urish/aramcon-badge/firmware/clicker/README.md

# Badge Clicker

## Installation

Copy [code.py](code.py) and [badgeio.py](../lib/badgeio.py) to your badge's USB Drive

## Usage

* Left button: Previous slide
* Right button: Next slide

Enjoy!

## Credits

* Applause sound taken from http://soundbible.com/2087-Audience-Applause.html
