urish/aramcon-badge/firmware/touch-piano/music.bmp

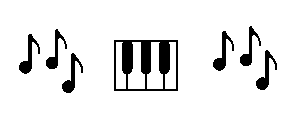
firmware/touch-piano/music.bmp
