urish/aramcon-badge/firmware/touch-screen/rgb.bmp

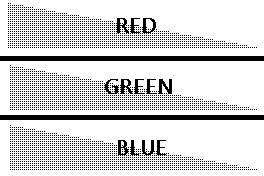
firmware/touch-screen/rgb.bmp
