urish/aramcon-badge/firmware/welcome/assets/welcome.bmp

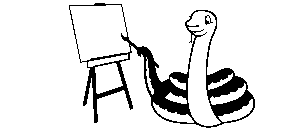
firmware/welcome/assets/welcome.bmp
