urish/aramcon-badge/pcbv2/3d-models/SFH11-xxPC-D03-ST-BK.STEP

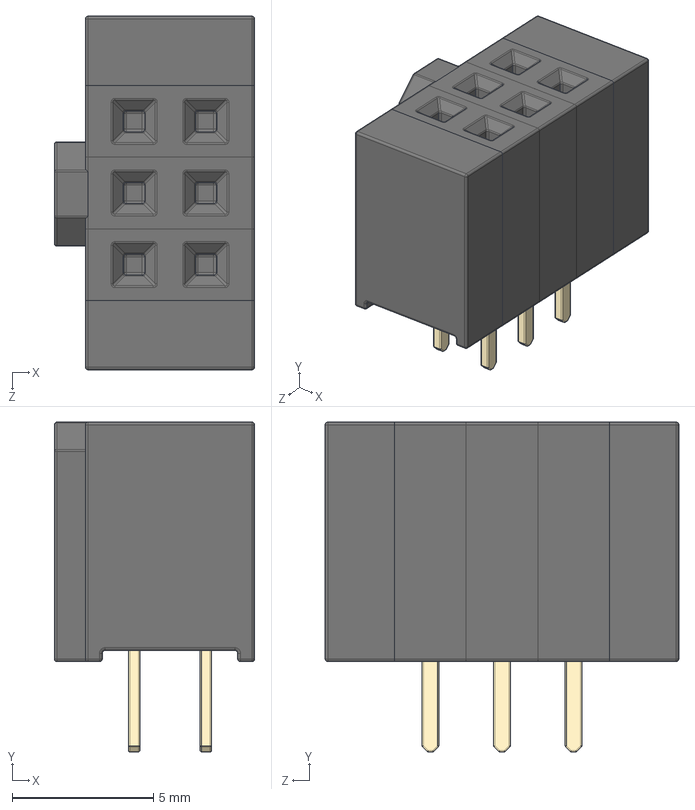
[picture p5: CAD file, 2019-10-17]
pcbv2/3d-models/SFH11-xxPC-D03-ST-BK.STEP
7.10 x 11.7 x 12.5 mm
body section with ST gold pins x 4
end x 2
Polarizing Key
