urish/aramcon-badge/pcbv2/3d-models/switch.step

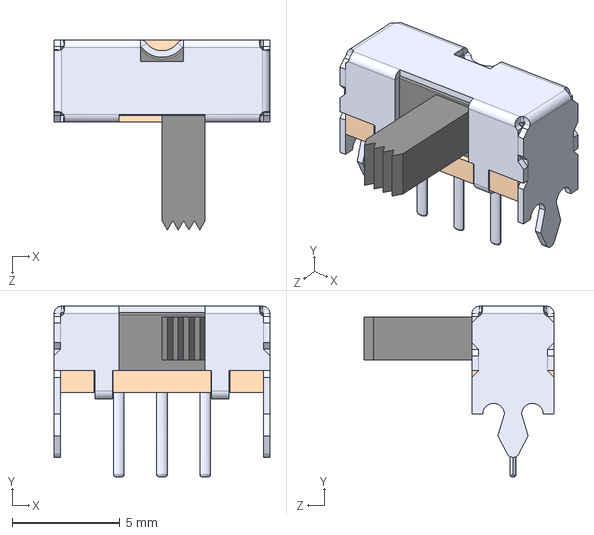
[picture p6: CAD file, 2019-10-12]
pcbv2/3d-models/switch.step
10.0 x 7.90 x 8.80 mm
