urish/aramcon-badge/(list of files, cad)

Other CAD files:
pcbv2/3d-models/switch.3mf
