urish/aramcon-badge/(commit log)

2018-11-23 feat: create KiCad project, add VS1053 symbol
    [badge.kicad_pcb, badge.sch]
2018-11-23 fix: wrong pin name in VS1053 symbol
2018-11-23 feat: add some initial connections to the mp3 player module
    [badge.sch]
2018-11-26 feat: add audio jack (TRRS) connector
    also assign footprints to symbols
    [badge.sch]
2018-12-10 Add MP3 breakout
    [badge.sch]
2018-12-10 Finish mp3 chip schematic
    [badge.sch]
2018-12-10 chore: add gitignore
    based on https://github.com/github/gitignore/blob/master/KiCad.gitignore
2018-12-10 Assign footprints
    [badge.sch]
2018-12-10 Start PCB layout
    [badge.kicad_pcb, badge.sch]
2018-12-10 Finish initial PCB layout
    This is only the sound module
    [badge.kicad_pcb, badge.sch]
2018-12-10 Update gerber (manufacturing) settings
    according to PCBWay guide:
    https://www.pcbway.com/blog/help_center/Generate_Gerber_file_from_Kicad.html
    [badge.kicad_pcb]
2018-12-20 Fix silk screen text: MOSI to MISO
    [badge.kicad_pcb]
2018-12-20 Move MP3 schematic to a new sheet
    - add micro usb connector
    - add ebyte module
    [MP3.sch, badge.sch]
2018-12-20 Add footprint for ebyte E73 nRF52840 module
2018-12-20 fix pin name in E73 symbol
2018-12-20 Fix names in MP3 sheet
    Add programming connector
    [MP3.sch, badge.sch]
2018-12-20 Mark pin 1 on silk screen for the VS1053B chip
    [badge.kicad_pcb]
2018-12-24 Add schematic for E paper display
    [Epaper.sch, MP3.sch, badge.sch]
2018-12-24 Fix ERC problems
    [Epaper.sch, MP3.sch, badge.sch]
2018-12-24 Add touch button symbols + footprints
    [Epaper.sch, badge.sch]
2018-12-24 Routing the CPU
    [MP3.sch, badge.kicad_pcb, badge.sch]
2018-12-24 Add courtyard layer to footprints
2018-12-24 Finish routing for display
    [badge.kicad_pcb]
2018-12-24 fix: add missing pin in E73 symbol
    Pin #1 was missing (P1.11)
    [badge.sch]
2018-12-24 Add power and indication LEDs
    [badge.kicad_pcb, badge.sch]
2018-12-24 Add silk screen text for breakout pins
    [badge.kicad_pcb]
2018-12-25 Add logo footprint
    [badge.kicad_pcb]
2018-12-25 Make logo smaller
    Resize with `-f 0.5` parameter for svg2mod
    [badge.kicad_pcb]
2018-12-25 Remove Paste layer from touch buttons
    [badge.kicad_pcb]
2018-12-25 feat: add conference logo to pcb
    [badge.kicad_pcb]
2018-12-29 fix(pcb): remove copper under BLE module antenna
    [badge.kicad_pcb]
2018-12-31 fix(pcb): remove "R7" from silk screen
    [badge.kicad_pcb]
2019-01-02 fix(epaper): update nRF pins for our own PCB
2019-01-02 Fix reversed connector for EPD
    [Epaper.sch, MP3.sch, badge.kicad_pcb]
2019-01-04 feat(pcb): add 2 neopixels
    [badge.kicad_pcb, badge.sch]
2019-01-05 add sample graphics for 2.7" and 2.9" displays
2019-01-12 feat(zephyr): initial working zephyr app
    simple blink app + board definition
2019-01-12 feat(zephyr): set up NeoPixel driver
2019-01-14 cleanup(pcb): remove touch buttons / slider
    [badge.kicad_pcb, badge.sch]
2019-01-14 feat(pcb): new board shape
    [badge-outline.dxf, badge.kicad_pcb]
2019-01-14 feat(pcb): add two more neopixels (schematic)
    [badge.sch]
2019-01-14 feat(pcb): add modified version of svg2mod
    Includes Python 3 fixes and some of the changes from:
    https://github.com/mtl/svg2mod/pull/26
2019-01-14 feat(pcb): create new footprint with board shape
    based on Elad's design. The shape is automatically generated from
    "board-shape.svg", along with the bottom silk screen and hints
    where to place various components
    [badge-outline.dxf, badge.kicad_pcb]
2019-01-14 feat(pcb): Add 3 Cherry MX buttons
    [badge.kicad_pcb, badge.sch]
2019-01-14 feat(pcb): add standard ARM-JTAG connector
    [badge.kicad_pcb, badge.sch]
2019-01-17 feat(pcb): reposition audio jack, display connector
    [badge.kicad_pcb]
2019-01-18 feat(pcb): mark pin 1 of the SWD connector
    [badge.kicad_pcb]
2019-01-18 feat(PCB): add SAO
    https://hackaday.com/2018/06/21/this-is-the-year-conference-badges-get-their-own-badges/shitty-add-on-standard/
    [badge.kicad_pcb, badge.sch]
2019-01-19 Added AA battery clip and regulator, only foorprint and symbols, no wiring yet.
    [badge.kicad_pcb, badge.sch]
2019-01-19 fix(pcb): use relative paths in symbol table
2019-01-19 fix(pcb): move conference logo down
    [badge.kicad_pcb]
2019-01-19 cleanup(PCB): remove display/sound headers from schematic
    [MP3.sch, badge.sch]
2019-01-19 cleanup(pcb): remove display / sound connectors from layout
    [badge.kicad_pcb]
2019-01-20 fix(pcb): improve board shape smoothness
    [badge.kicad_pcb]
2019-01-20 fix(pcb): move BLE module to edge of board
    we need to reroute everything again :q
    [badge.kicad_pcb]
2019-01-21 Add missing pins to E73 symbol
    [badge.sch]
2019-01-21 Add Flash memory + connect battery and step-up IC
    [MP3.sch, badge.sch]
2019-01-21 Add vibrator
    [badge.sch]
2019-01-21 PCB routing
    [badge.kicad_pcb, badge.sch]
2019-01-21 feat(pcb): complete layout
    [badge.kicad_pcb]
2019-01-21 feat(pcb): add texts to switch, indicate SAO VCC pin
    [badge.kicad_pcb]
2019-01-21 fix(pcb): change step-up resistor to 390R
    400R is not a common value, 390 is.
    [badge.kicad_pcb, badge.sch]
2019-01-23 feat(pcb): add tiny-sao pcb
    [tiny-sao.kicad_pcb, tiny-sao.sch]
2019-01-24 refactor(pcb): move power schematic to a separate sheet
    [Epaper.sch, MP3.sch, badge.kicad_pcb, badge.sch, power.sch]
2019-01-24 feat(pcb): add battery reverse polarity protection
    [badge.kicad_pcb, power.sch]
2019-01-25 feat(pcb): add indication LED to tiny-sao
    [tiny-sao.kicad_pcb, tiny-sao.sch]
2019-01-25 feat(pcb): add LIS2DH12TR accelerometer
    [badge.kicad_pcb, badge.sch]
2019-01-25 cleanup(pcb): remove unused files
    also move all symbol libraries into the `lib` folder
2019-02-03 fix(pcb): mark pin 1 of the flash memory (U5)
    [badge.kicad_pcb]
2019-02-04 moved C16 and moved pads in EBYTE footprint
    moved C16 closer to U4.
    [badge.kicad_pcb]
2019-02-04 fix(pcb): C16 label position
    [badge.kicad_pcb]
2019-02-05 feat(epaper): implement basic IL0373 driver
    no support for partial updates at this stage
2019-02-08 fix(zephyr): fix ws2812 compilation error
    Move WS2812 settings to device tree, per changes in Zephyr:
    https://github.com/zephyrproject-rtos/zephyr/commit/8b691f50ca
2019-02-08 feat(zephyr): add button definitions to board dts
2019-02-08 feat(zephyr): switch to RTT logger
    open virtual logging console over JLink
2019-02-08 fix(zephyr): fix board clock configuration
    use RC for lowfreq clock (instead of external crystal that we don't have)
2019-02-08 fix(zephyr): fix SPI and I2C pin configuration
    they were conflicting with the ePaper pins, causing it not to function
    also remove uart0, we have no uart pins on our board
2019-02-08 feat(zephyr): add epaper device
    seems to be half-working on the waveshare module
2019-02-09 feat(zephyr): display battery voltage
2019-02-09 fix(zephyr): board configuration
2019-02-09 fix(pcb): hide switch designators from silkscreen
    [badge.kicad_pcb]
2019-02-09 feat(zephyr): add accelerometer dts
2019-02-10 feat(pcb): add test-points for programming
    add GND, SWCLK, SWDIO, 3V3 with standard 0.1" spacing
    [badge.kicad_pcb, badge.sch]
2019-02-11 feat(zephyr): add code to test buttons
2019-02-11 fix(zephyr): invert buttons, simplify loop code
2019-02-11 fix(zephyr): fix pin collision between SPI2 and SW2
2019-02-11 feat(zephyr): add vibration motor (controlled by middle button)
2019-02-15 refactored buttons out of zephyr code
2019-02-15 removed button aliases
2019-02-17 feat(nametags): implement nametags app + webpage
    🛫
2019-02-22 refactored out led code
2019-02-22 Refactored vibration motor out of main
2019-02-22 fixed magic number in buttons.c
2019-02-22 moved drivers to seperate folder
2019-02-22 refactored battery voltage out of main
2019-02-23 fix(pcb): update R11 value to 0.47R
    This is due to switching our EPaper display panel to GDEW029T5,
    which requires a smaller resistor value than the original Waveshare panel
    [Epaper.sch, badge.kicad_pcb]
2019-02-28 feat(zephyr) VS1003B driver skeleton
    + code for basic sanity test
2019-03-15 fix(pcb): correct "Placement Type" setting
    - SMD placement for U3, BT1
    - Virtual placement for SHAPE, svg2mod
    - Also Virtual for J6, as it is not assembled by default
    [badge.kicad_pcb]
2019-04-13 feat(zephyr): migrate to good-display driver
2019-04-15 feat(web): implement device filtering
    look at the query param `b` to decide which badge we want to connect to
2019-04-15 feat(nametags): report battery voltage to web app
    also update the web app to display the voltage
2019-04-15 feat(nametags): implement keyboard driver
    it exposes a queue of key events, and includes a debouncing mechanism
2019-04-15 refactor(nametags): break code to drivers
2019-04-15 feat(nametags): implement led breathe
    using PWM
2019-04-16 feat(nametags): implement BLE scanner
    this allows mass-remote control of LEDs
2019-04-16 fix(web): switch font to Roboto
2019-04-17 fix(hardware-test): fix sound driver
    send the correct buffer size when writing to SPI
2019-04-17 feat(hardware-test): sound driver
    implement missing vs1053 functionality
2019-04-17 added sound driver from hwtest
2019-04-18 fix(nametags): improve sound driver performance
    - don't perform double sanity check
    - initialize sound faster in case the chip is missing
    - play 500hz tone (instead of 3khz)
2019-04-23 feat(js): driver for IL0373 display
2019-04-23 fix(js): speed up il0373
    call spi.write() instead of spi.send()
2019-04-24 fix(clock): auto update time every minute
    [main.py]
2019-05-08 fix(pcb): add capacitor for the buzzer
    [badge.kicad_pcb, badge.sch]
2019-05-16 Added circuitpython test programs
2019-06-27 Add setup instructions for circuitpython
2019-08-13 Added customizable-badge to circuitpython apps
2019-08-13 feat: add badgeio library for CircuitPython
2019-08-13 feat(badgeio): add battery_voltage property
2019-08-13 feat(badgeio): add i2c property
2019-08-13 fix(badgeio): NEOPIXELS → NEOPIXEL
    sync with change in our CircuitPython board definition
2019-08-13 feat(badgeio): add display, display_bus, spi
2019-08-13 refactor: make circuitpython the default firmware
    moved zephyr firmware to a separate branch:
    https://github.com/urish/aramcon-badge/tree/zephyr-firmware
    and removed all zephyr related files from the master branch.
    Updated the README accordingly
2019-08-28 cleanup(pcb): remove tiny-sao board
    move to own repository:
    https://github.com/urish/ctf-shittyaddon
    [tiny-sao.kicad_pcb, tiny-sao.sch]
2019-08-29 feat(firmware): start porting nametags to python
    currently displays the conference banner + qr code
2019-08-29 feat(firmware): add sound support to badgeio
    also add sineTest() method to vs1053 driver
2019-08-29 fix(clock): use new display API
    [main.py]
2019-08-30 Fixed some circuitpython drivers
2019-08-30 Rock paper scissors: Fixed bug in join_game
    [code.py]
2019-08-30 fix(rock-paper-scissor): don't block if session disconnects
    [code.py]
2019-08-31 feat(nametags): persistence + bug fixes
    * persistence - store bitmap to flash
    * improve LED spinner
    * implement battery voltage characteristic
    * resume advertising after disconnect
    * rename main.py → code.py for consistency with other projects
    [bitmapsave.py, code.py, led_spinner.py, main.py, name_server.py, ui.py]
2019-09-02 doc(pcb): add illustration of the board front
2019-09-22 feat(badgeio): lazy init accelerometer
2019-10-05 feat(pcbv2): start working on the 2020 edition
    Changes so far:
    1. Replace the Micro USB connector with a USB Type C connector
    2. Upgrade ShittyAddon to V. 1.69bis
    3. Remove the VS1003 audio CODEC chip, audio jack, and related components
    4. Remove the custom board shape
    5. Add SOICbite connector for programming (in place of the TPs)
    References:
    * SOICbite - https://github.com/SimonMerrett/SOICbite
    * Shitty Addon V. 1.69bis - https://hackaday.io/project/52950-shitty-add-ons/log/159806-introducing-the-shitty-add-on-v169bis-standard
    [Epaper.sch, badge2.kicad_pcb, badge2.sch, power.sch]
2019-10-08 feat(pcbv2): add LiPo module
    [Epaper.sch, badge2.sch, lipo.sch, power.sch]
2019-10-11 feat(pcbv2): remove 2 neopixels
    We only want two in the new design
    [badge2.sch]
2019-10-11 feat(pcbv2): replace keyboard buttons with 6x6 buttons
    Now we have 4 buttons: top/left/right/down instead of the 3 keyboard buttons we used to have
    [badge2.kicad_pcb, badge2.sch, lipo.sch]
2019-10-11 feat(pcbv2): new design / board layout
    see badge-2020.svg
    [badge2.kicad_pcb]
2019-10-11 feat(pcbv2): add action button
    [badge2.kicad_pcb, badge2.sch]
2019-10-11 refactor(pcbv2): move accelerometer to own sheet
    [Epaper.sch, accelerometer.sch, badge2.kicad_pcb, badge2.sch, lipo.sch, power.sch]
2019-10-11 feat(pcbv2): add FM module connector
    [badge2.kicad_pcb, badge2.sch]
2019-10-11 fix(pcbv2): move usb-c connector a bit down
    so it doesn't collide with the down button
    [badge2.kicad_pcb]
2019-10-11 feat(pcbv2): add reset button
    [badge2.kicad_pcb, badge2.sch]
2019-10-12 fix(pcbv2): simplify board SVG
    [badge2.kicad_pcb]
2019-10-12 fix(pcbv2): move power components together
    [badge2.kicad_pcb]
2019-10-12 feat(pcbv2): add 3d model for the EByte module
    [E73-2G4M08S1C.scad, badge2.kicad_pcb]
2019-10-12 feat(pcbv2): add copper zones
    [badge2.kicad_pcb]
2019-10-12 feat(pcbv2): 3d models for buttons + switch
    [badge2.kicad_pcb, switch.step]
2019-10-12 feat(pcbv2): move SOICbite, add reset to PCB
    move SOICbite to the other side of the board, add reset button to the PCB,
    start routing flash and power LED
    [badge2.kicad_pcb]
2019-10-16 cleanup(pcbv2): remove Cortex-M connector
    [badge2.kicad_pcb, badge2.sch]
2019-10-16 feat(pcbv2): replace flash memory
    Upgrade flash to 128MBit (16MByte):
    GD25Q16C → W25Q128JVS
    The new flash chip has a different package (SOIC-8 208-mil), so the PCB was updated with the new footprint
    [badge2.kicad_pcb, badge2.sch]
2019-10-17 fix(pcbv2): reconnect VUSB pin
    also add decoupling cap on VUSB, as recommended in nRF reference design
    [badge2.kicad_pcb, badge2.sch]
2019-10-17 feat(pcbv2): replace SAO footprint with the official one
    also add a 3D model
    [SFH11-xxPC-D03-ST-BK.STEP, badge2.kicad_pcb, badge2.sch]
2019-10-18 fix(pcbv2): SAO orientation
    Make it compatible with last year's badge
    [badge2.kicad_pcb]
2019-10-22 feat(pcbv2): add LCSC part# for USB Type C connector
    [badge2.sch]
2019-10-24 feat(pcbv2): add part numbers to schematics
    mostly LCSC / Digikey. Some components still missing, will
    add them soon.
    [Epaper.sch, accelerometer.sch, badge2.sch, power.sch]
2019-10-25 Added bcaaapc foorprint for AAA battery holder. This is based on http://www.memoryprotectiondevices.com/datasheets/BCAAAPC-datasheet.pdf
2019-10-25 Downloaded a JST-B2B-PH-K-S socket footprint and labeled its pins.
2019-10-25 feat(pcbv2): add BOM part numbers
    most parts there there, still missing a few
    [Epaper.sch, badge2.sch, lipo.sch, power.sch]
2019-10-25 feat(pcbv2): add missing parts to BOM
    [badge2.sch]
2019-10-30 feat(pcbv2): add cross hole
    [badge2.kicad_pcb]
2019-10-30 fix(pcbv2): adjust clearance for U7, USB-C pads
    [badge2.kicad_pcb]
2019-10-30 fix(pcbv2): move SOICbite silk labels
    [badge2.kicad_pcb]
2019-11-01 Modify JST and AAA sockets to have matching pin labels
2019-11-01 Placed new AAA and JST battery holders on PCB
    [badge2.kicad_pcb]
2019-11-01 Added battery holders BOM data
    [Epaper.sch, accelerometer.sch, badge2.sch, lipo.sch, power.sch]
2019-11-01 fix(pcbv2): broken schematic symbols
    [Epaper.sch, accelerometer.sch, badge2.sch, lipo.sch, power.sch, switch.3mf]
2019-11-01 fix(pcbv2): sprinkle no-connection flags
    [badge2.sch]
2019-11-01 fix(pcbv2): sync pcb with schematic
    [badge2.kicad_pcb]
2019-11-01 feat(pcbv2): connect remaining pins of FM module
    also remove unused MISO pin
    [badge2.sch]
2019-11-01 fix(pcbv2): remove AMS1117-3.3 regulator
    We already have RT9013-33GB that does the same.
    This also fixes an issue where the power switch would not be able to cut USB/LiPo power.
    Also move LiPo circuit into power schematic.
    [Epaper.sch, accelerometer.sch, badge2.sch, lipo.sch, power.sch]
2019-11-01 fix(pcbv2): remove references to missing fp libraries
2019-11-01 feat(pcbv2): wiring
    [badge2.kicad_pcb]
2019-11-01 feat(pcbv2): even more wiring
    [badge2.kicad_pcb]
2019-11-01 feat(pcbv2): finish wiring
    [badge2.kicad_pcb]
2019-11-03 fix(pcbv2): add pull-down resistor to vibration motor
    This ensures the vibration motor doesn't randomally go start before the MCU configures the respective GPIO to output
    The new resistor is R9
    [badge2.kicad_pcb, badge2.sch]
2019-11-03 feat(pcbv2): improve LiPo charging circuit
    Add a transistor (Q3), that cuts the power from the LiPo when USB is connected,
    allowing us to separate the battery from the rest of the circuit
    while it's being charged.
    [badge2.kicad_pcb, power.sch]
2019-11-03 fix(pcbv2): usb type-c connector footprint
    [badge2.kicad_pcb]
2019-11-03 fix(pcbv2): move the USB connector closer to board edge
    [badge2.kicad_pcb]
2019-11-03 fix(pcbv2): improve routing
    [badge2.kicad_pcb]
2019-11-04 fix(pcbv2): Q3 mosfet orientation
    [badge2.kicad_pcb, power.sch]
2019-11-08 feat(firmware): add led-matrix-sao example
2019-11-08 Added Rev label
    [badge2.kicad_pcb]
2019-11-08 Some zones were unfilled so I chose to fill before generating plot
    [badge2.kicad_pcb]
2019-11-09 feat(lib): add-on driver
2019-12-13 fix(pcb): refill zones
    KiCad 5.1.4 works slightly different than 5.0.2 which Elad uses
    [badge2.kicad_pcb]
2019-12-13 feat(pcbv2): mark LED and buzzer orientation
    [badge2.kicad_pcb]
2019-12-27 feat(lib): lazy-init I2C in badgeio
2019-12-27 feat(eeprom): add EEPROM-VFS driver
2019-12-29 fix(pcbv2): mark AAA battery polarity on silk layer
    [badge2.kicad_pcb]
2020-01-01 feat(lib): add SI4703 driver
2020-01-01 doc(pcbv2): explain battery load sharing system
    add link to the relevant application note from the schematic
    [power.sch]
2020-01-02 fix(pcbv2): update schematic cache lib
    using kicad 5.1.5-3
2020-01-02 fix(pcbv2): change green LED resistors to 390ohm
    4.7k caused them to be too dim
    [badge2.sch]
2020-01-02 chore(pcbv2): update schematic to latest kicad
    not a major update, just minor things that shouldn't affect previous versions
    [Epaper.sch, accelerometer.sch]
2020-01-02 feat(pcbv2): add AAA/LiPo symbols next to power switch
    [badge2.kicad_pcb]
2020-01-02 fix(pcbv2): reverse polarity of LiPo connector
    [badge2.kicad_pcb]
2020-01-02 cleanup(pcbv2): remove "Rev 1.0" text
    [badge2.kicad_pcb]
2020-01-02 fix(pcbv2): sprinkle vias
    also connect some ground island (according to kicad)
    [badge2.kicad_pcb]
2020-01-02 feat(pcbv2): add I2C pullup resistors
    R6/R7, 10k ohm
    [accelerometer.sch, badge2.kicad_pcb, badge2.sch]
2020-01-04 feat(pcbv2): add dot below logo
    [badge2.kicad_pcb]
2020-01-04 feat(pcbv2): add pin labels to FM connector
    [badge2.kicad_pcb]
2020-01-04 feat(pcbv2): add conference logo
    [badge2.kicad_pcb]
2020-01-07 feat: new footprint for front buttons
    - K2-1102ST-A4SC-04
    - K2-1102SP-B4SC-04
2020-01-08 fix(pcbv2): replace button footprints
    make them compatible with K2-1102ST-A4SC-04
    and K2-1102SP-B4SC-04, which are still 6mm SMT buttons,
    but have a slightly different footprint (11mm across)
    [badge2.kicad_pcb]
2020-01-08 fix(pcbv2): routing improvements
    1. move DISPCS via away from pad
    2. thicker power tracks to main MCU (GND / VCC)
    [badge2.kicad_pcb]
2020-01-10 fix(badgeio): accelerometer code broken
2020-01-11 Fixed AAA bat holder pin hole size, it was too small. It is now based on this - http://www.memoryprotectiondevices.com/datasheets/BCAAAPC-datasheet.pdf
    [badge2.kicad_pcb]
2020-01-11 Created a smaller hole diameter footprint for the buzzer, based on AWG 32 and 7 windes (like it says here - https://media.digikey.com/pdf/Data%20Sheets/Seeed%20Technology/1020-15-003-001_Spec.pdf). H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
    [badge2.kicad_pcb, badge2.sch]
